zhanghongchen1213/DIY_hyrobot/hy_ros/docs/source/index.rst

黄油机器人复刻教程
==================

这里汇集黄油机器人的项目介绍、硬件资料和软件部署方法。
可以从准备工作开始逐步复刻，也可以按需查阅语音交互、视觉检测、建图定位等功能章节。

.. toctree::
   :maxdepth: 1
   :caption: 项目介绍

   1_product_introduction

.. toctree::
   :maxdepth: 1
   :caption: 开始复刻

   project_status
   7_Resources

.. toctree::
   :maxdepth: 2
   :caption: 复刻步骤

   3_Development_instructions

.. toctree::
   :maxdepth: 1
   :caption: 扩展学习

   development/model_training
   development/navigation

.. toctree::
   :maxdepth: 1
   :caption: 参考资料

   6_Reference_links
