zhanghongchen1213/DIY_hyrobot/hy_ros/resources/project/0.RK3588S/3.butter_yolov8n/butter.jpg

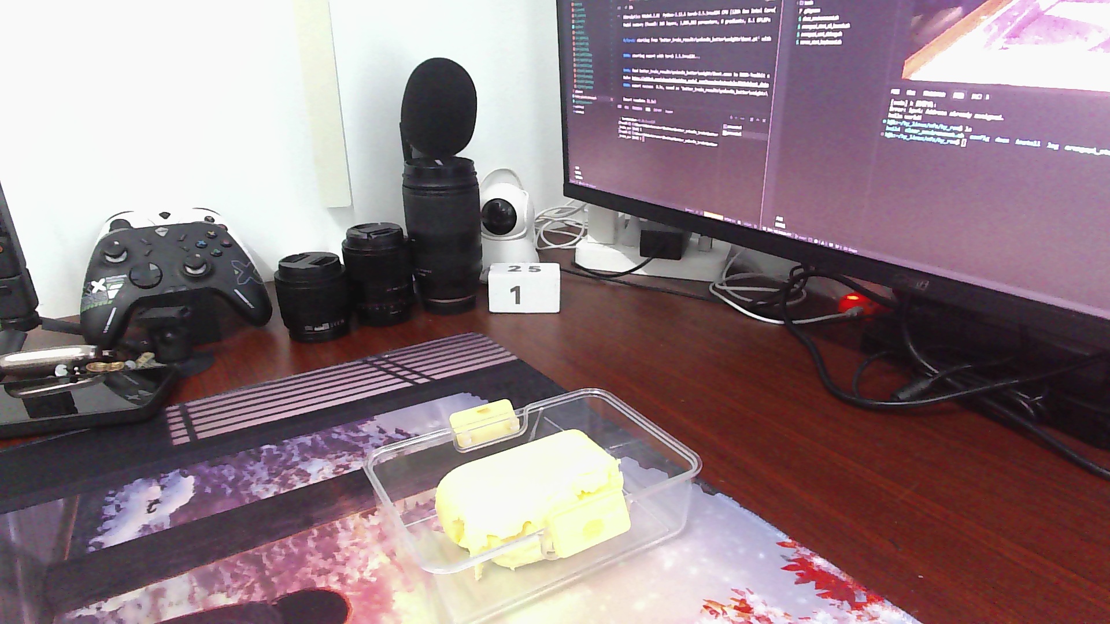
hy_ros/resources/project/0.RK3588S/3.butter_yolov8n/butter.jpg
