zhanghongchen1213/DIY_hyrobot/hy_ros/src/butter_robot_description/meshes/right_arm_Link.STL

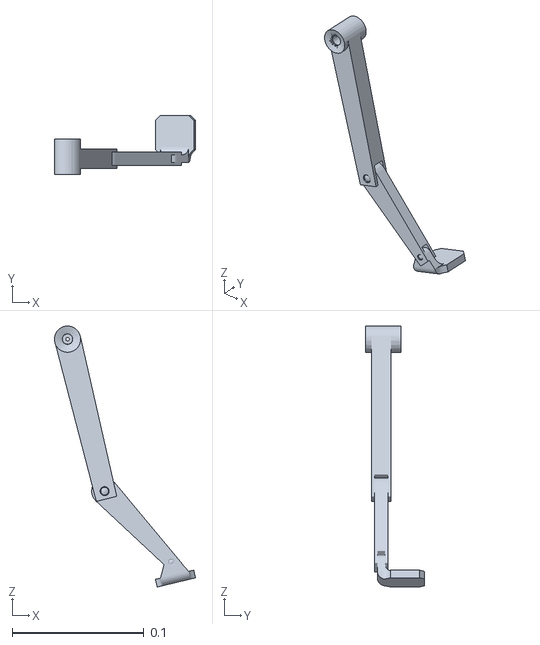
[picture p17: CAD file, 2026-10-13]
hy_ros/src/butter_robot_description/meshes/right_arm_Link.STL
0.107 x 0.0452 x 0.198
