zhanghongchen1213/DIY_hyrobot/hy_ros/src/butter_robot_description/meshes/left_wheel_Link.STL

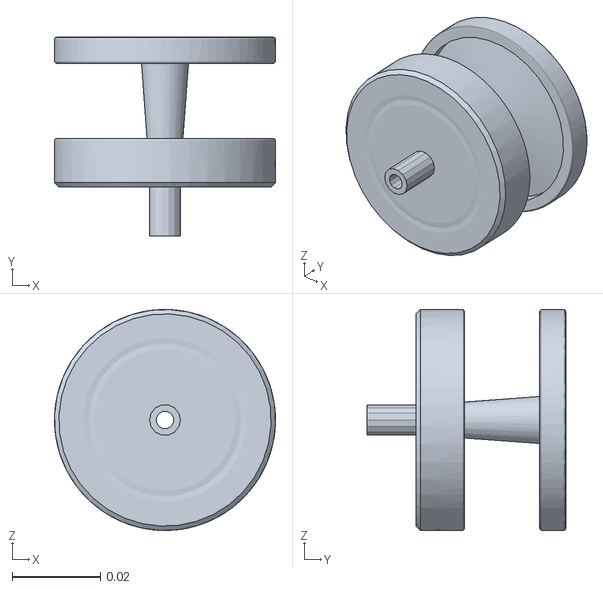
[picture p18: CAD file, 2026-10-13]
hy_ros/src/butter_robot_description/meshes/left_wheel_Link.STL
0.05 x 0.0449 x 0.05
