zhanghongchen1213/DIY_hyrobot/hy_ros/src/butter_robot_description/meshes/radar_Link.STL

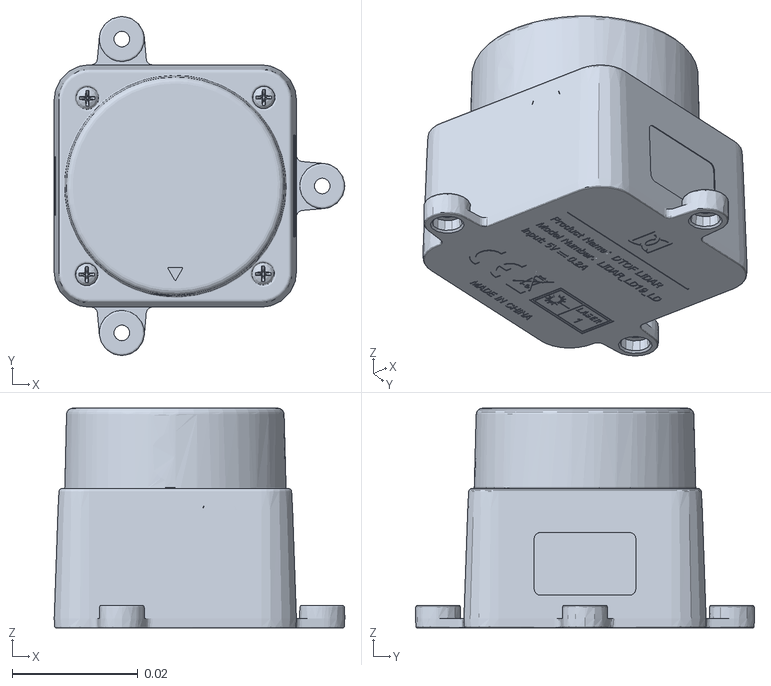
[picture p19: CAD file, 2026-10-13]
hy_ros/src/butter_robot_description/meshes/radar_Link.STL
0.0463 x 0.054 x 0.035
