zhanghongchen1213/DIY_hyrobot/hy_ros/src/butter_robot_description/meshes/spine_Link.STL

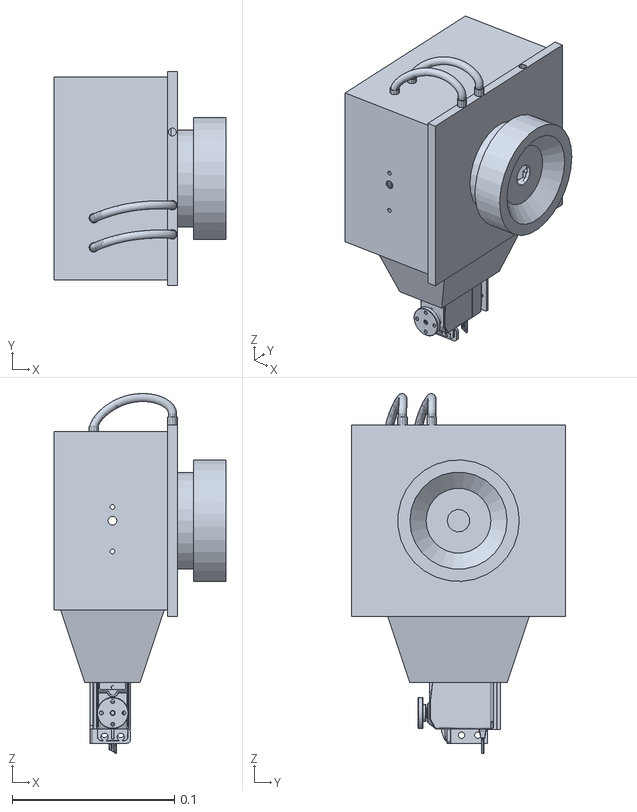
[picture p20: CAD file, 2026-10-13]
hy_ros/src/butter_robot_description/meshes/spine_Link.STL
0.106 x 0.132 x 0.222
