zhanghongchen1213/DIY_hyrobot/(list of files, cad)

Other CAD files:
hy_ros/src/butter_robot_description/meshes/left_arm_Link.STL
