zhanghongchen1213/DIY_hyrobot/butter_yolov8n_train/butter_train_results/yolov8n_butter/P_curve.png

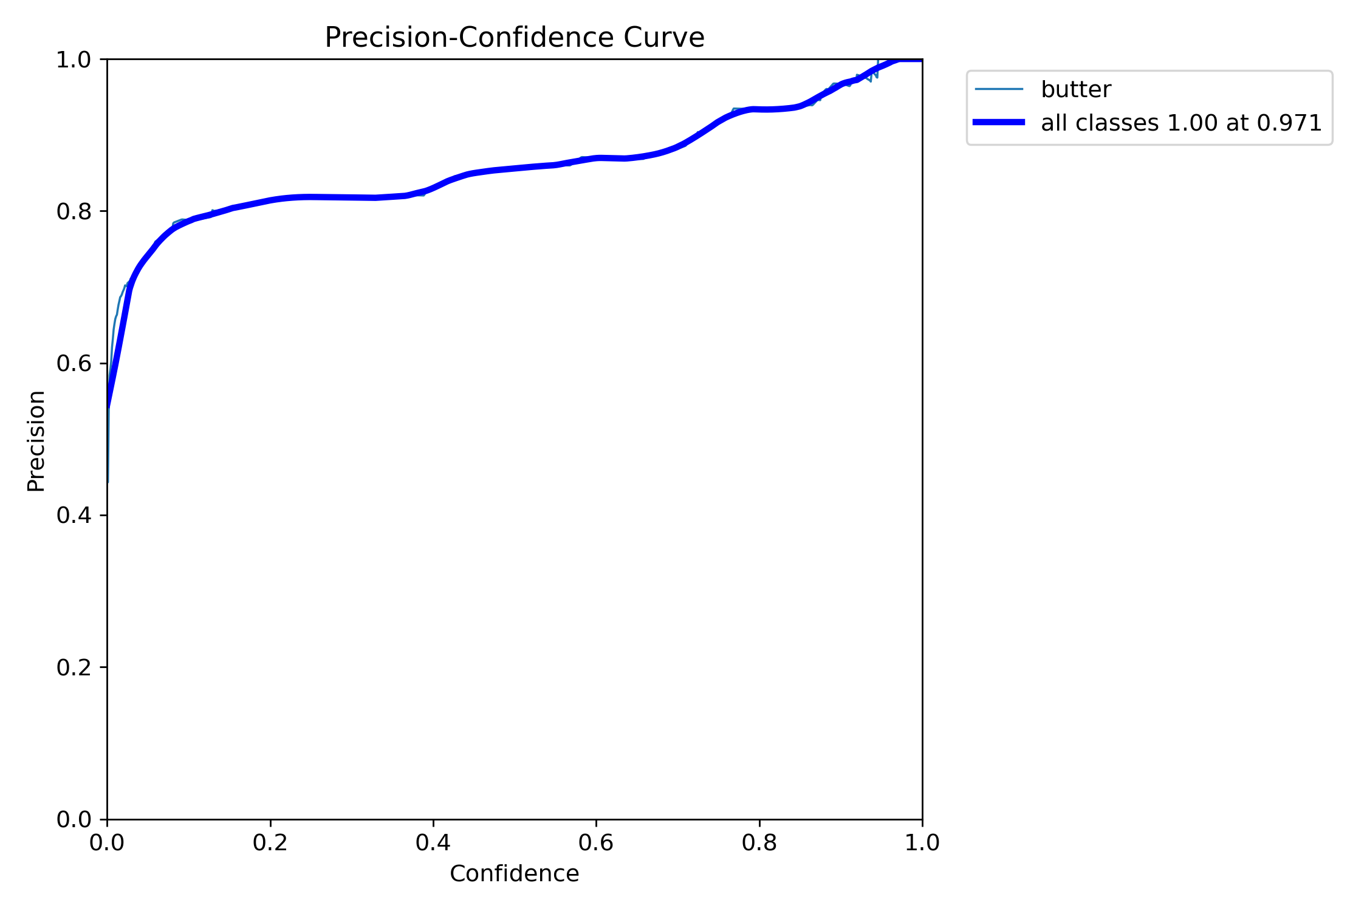
butter_yolov8n_train/butter_train_results/yolov8n_butter/P_curve.png
