zhanghongchen1213/DIY_hyrobot/butter_yolov8n_train/butter_train_results/yolov8n_butter/val_batch1_labels.jpg

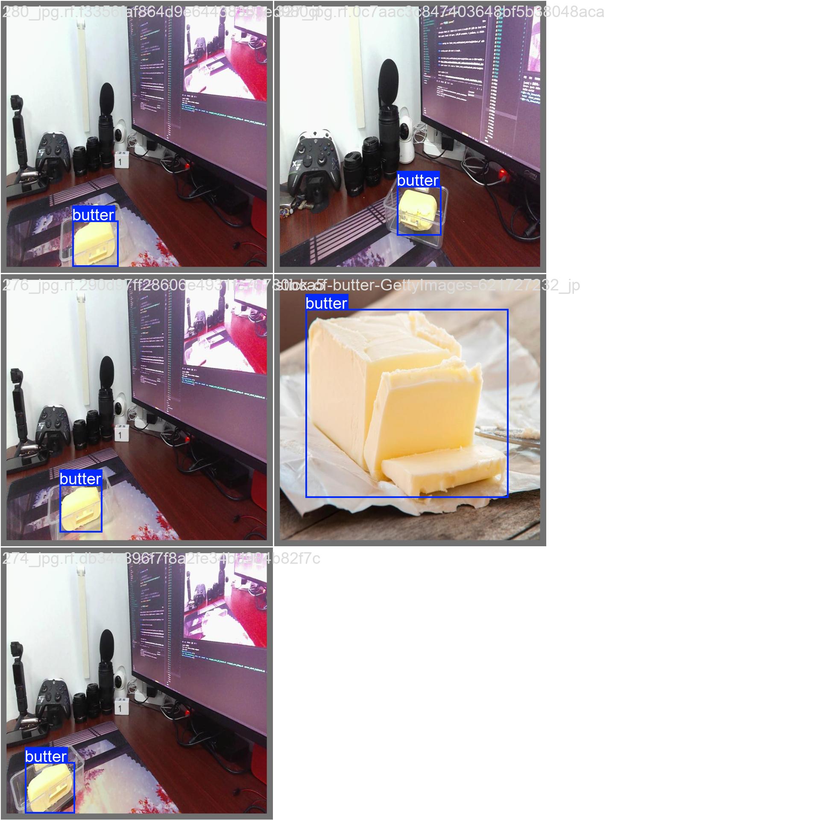
butter_yolov8n_train/butter_train_results/yolov8n_butter/val_batch1_labels.jpg
