zhanghongchen1213/DIY_hyrobot/hy_ros/src/hy_slam/docs/DEBUG_LOG.md

# hy_slam 功能包调试日志

**项目**: 黄油机器人 ROS2 SLAM 系统
**功能包**: hy_slam
**调试日期**: 2026-01-22
**调试目标**: 实现 SLAM 建图、定位和雷达过滤三个核心功能

---

## 问题清单

###

---

**文档维护者**: Claude Code (Anthropic AI Assistant)
**最后更新**: 2026-01-20
**版本**: v1.0
