zhanghongchen1213/DIY_hyrobot/(commit log)

2026-10-14 ``` docs(repo): 重写各模块 README 为技术文档风格
    - 移除营销推广内容（购买链接、视频演示、产品外观图片等）
    - 根 README 补充项目目录表格、运行环境入口、文档构建命令及维护说明
    - 新增 butter_train_env/README.md 说明 uv 环境与内核配置
    - 重写 butter_yolov8n_train/readme.md 为训练与部署技术文档
    - 重写 hy_driver/readme.md 为固件构建、模块接口与已知问题文档
    - hardware/README.md 补充资料边界与 Python 版本要求
    ```
2026-10-26 ``` docs: 移除 Sphinx 文档系统并重写仓库 README
    - 删除 Read the Docs 配置（根目录和 hy_ros 下的 .readthedocs.yaml）
    - 删除 Sphinx 构建工具链（Makefile、make.bat、preview.ps1、
    auto_build.sh）
    - 删除文档依赖清单（requirements.txt）和文档 README
    - 新增根目录 MIT LICENSE 文件
    - 在 pyproject.toml 中声明 license 字段
    - 重写仓库 README，整合功能说明、运行指南、目录结构和
    常见问题排查表
    - 更新各模块 README 中的交叉引用，指向新的文档位置
    - 清理 .gitignore 中已失效的 /docs/.venv/ 条目
    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
